Alirio926/snescart/my snescart.pdf

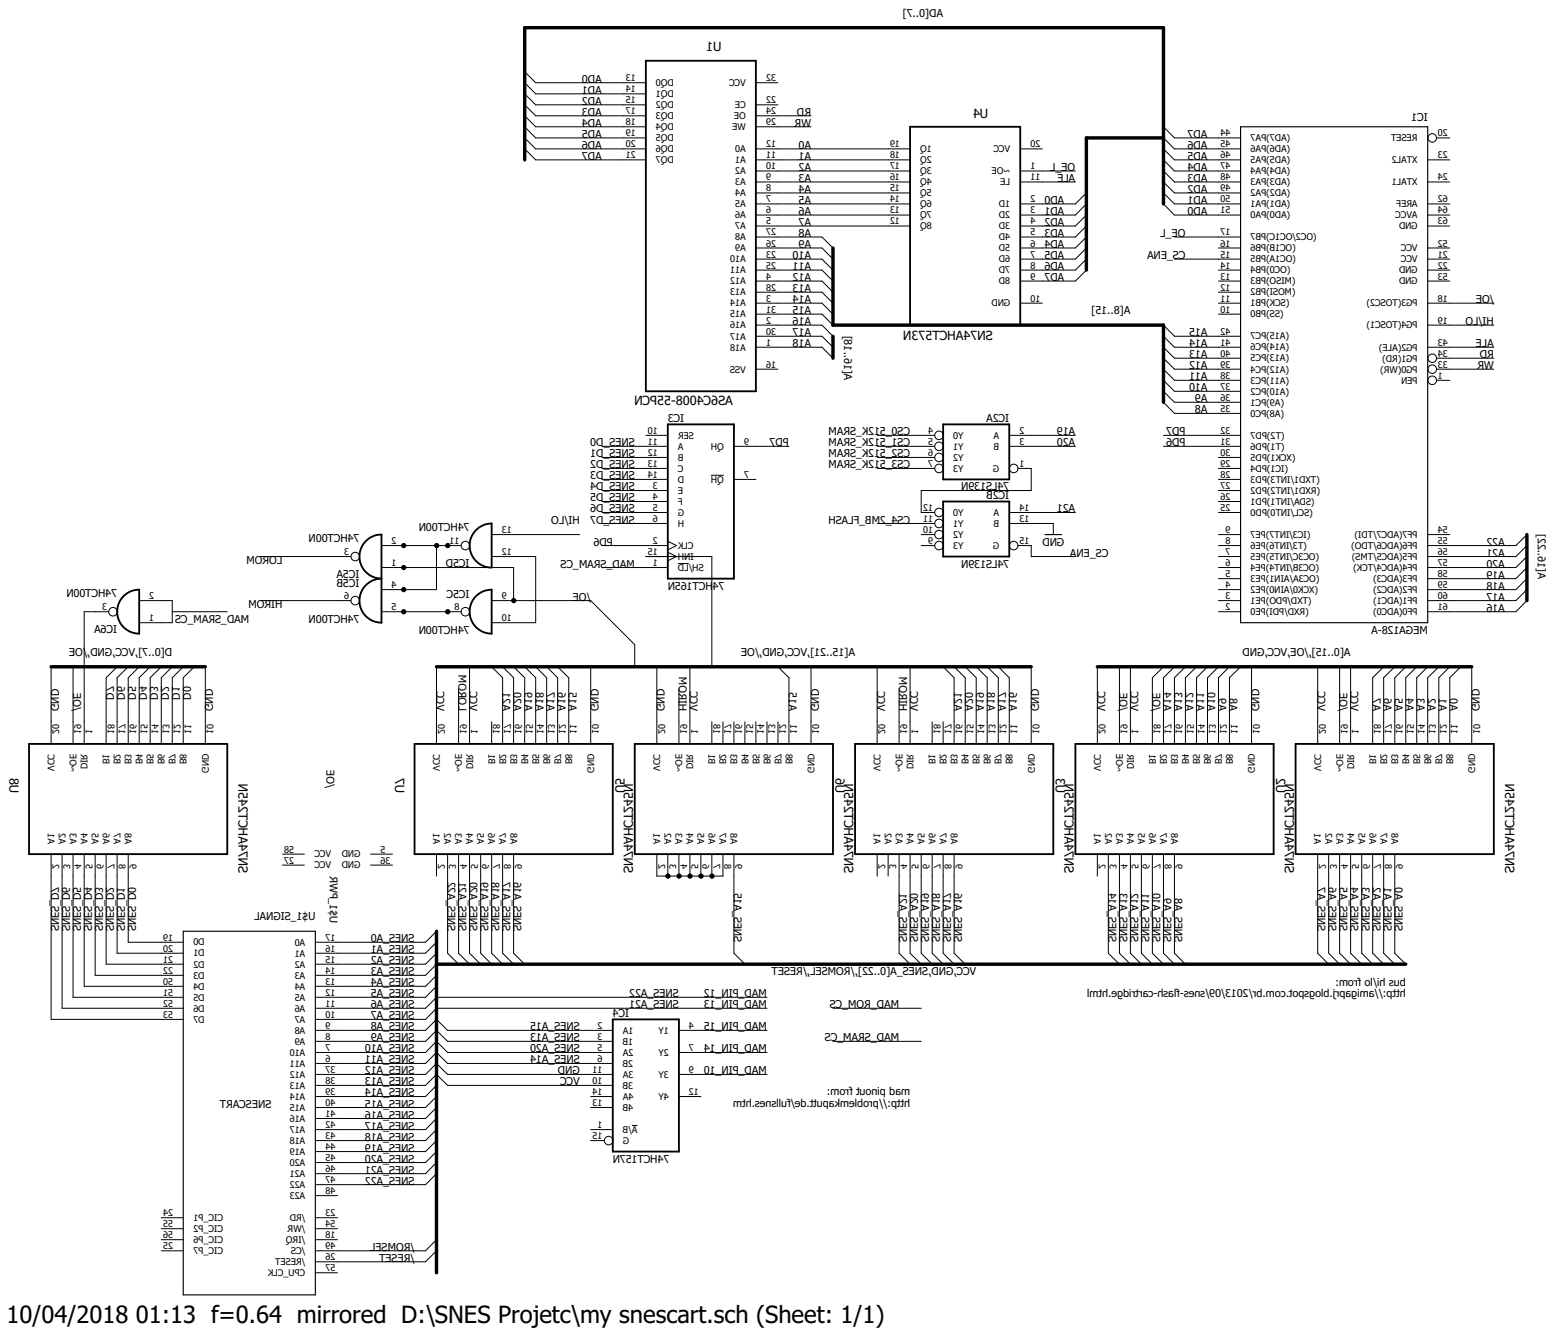
[picture p4: page 1]

10/04/2018 01:13 f=0.64 mirrored D:\SNES Projetc\my snescart.sch (Sheet: 1/1)
