Alirio926/snescart/SnesCart/SnesCart/spi/SPI_routines.h

//**************************************************************
// ****** FUNCTIONS FOR SPI COMMUNICATION *******
//**************************************************************
//Controller: ATmega8 (Clock: 8 Mhz-internal)
//Compiler: AVR-GCC
//Version : 2.0
//Author: CC Dharmani, Chennai (India)
// www.dharmanitech.com
//Date: 26 Feb 2009
//**************************************************************

//**************************************************
// ***** HEADER FILE : SPI_routines.h ******
//**************************************************
#ifndef _SPI_ROUTINES_H_
#define _SPI_ROUTINES_H_
#define SPI_SD             SPCR = 0x52
#define SPI_HIGH_SPEED     SPCR = 0x50; SPSR |= (1<<SPI2X)

void spi_init(void);
unsigned char SPI_transmit(unsigned char);
unsigned char SPI_receive(void);

#endif
